karwantes/Nuaire-MVHR/docs/images/bus_connector_front.jpg

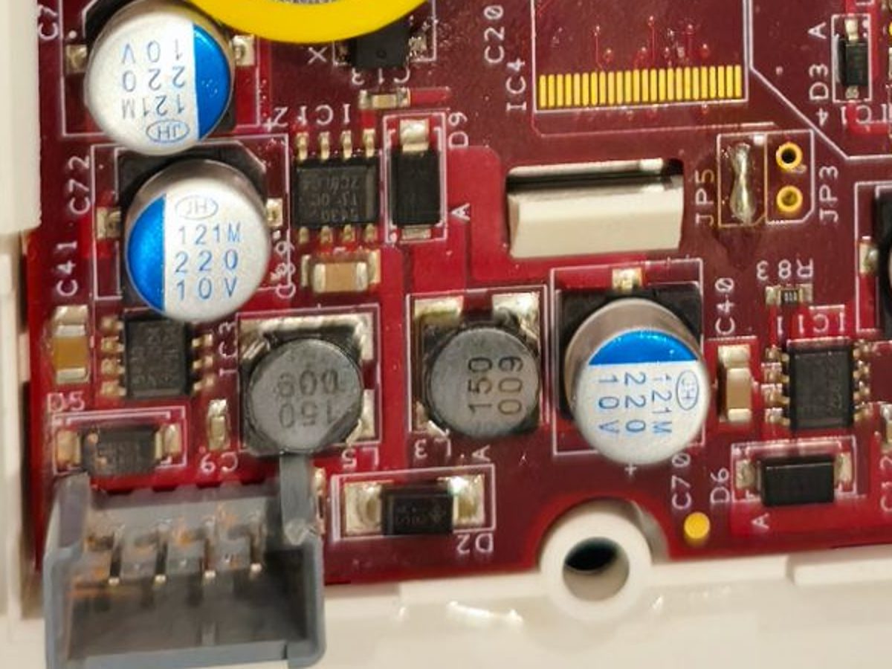
docs/images/bus_connector_front.jpg
