karwantes/Nuaire-MVHR/docs/images/bus_pads_back.jpg

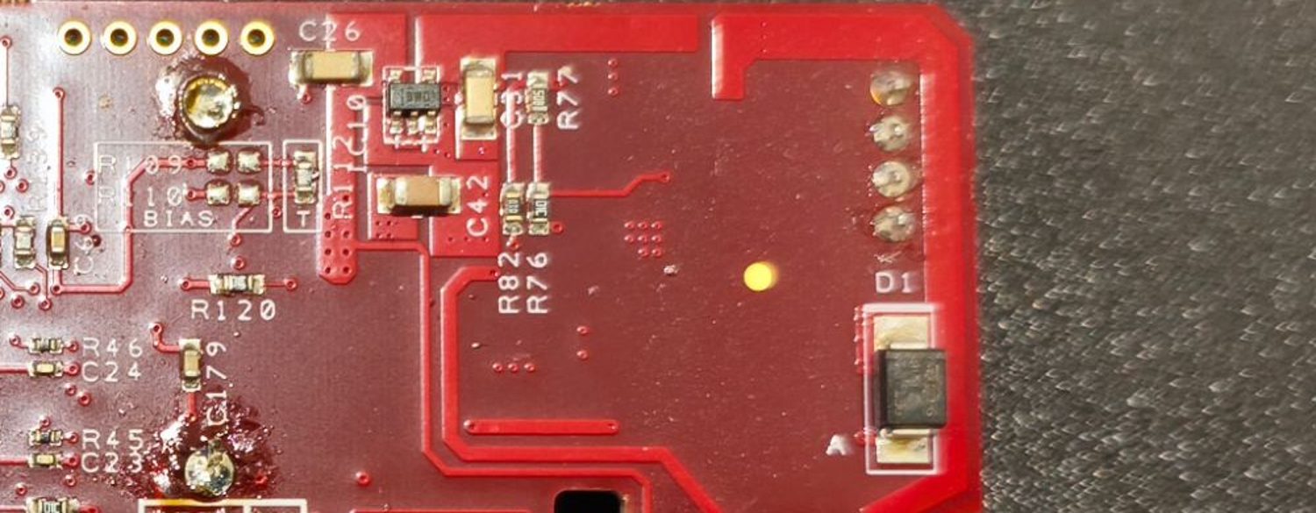
docs/images/bus_pads_back.jpg
