karwantes/Nuaire-MVHR/card/qa/screenshots/aircon-off-phone.png

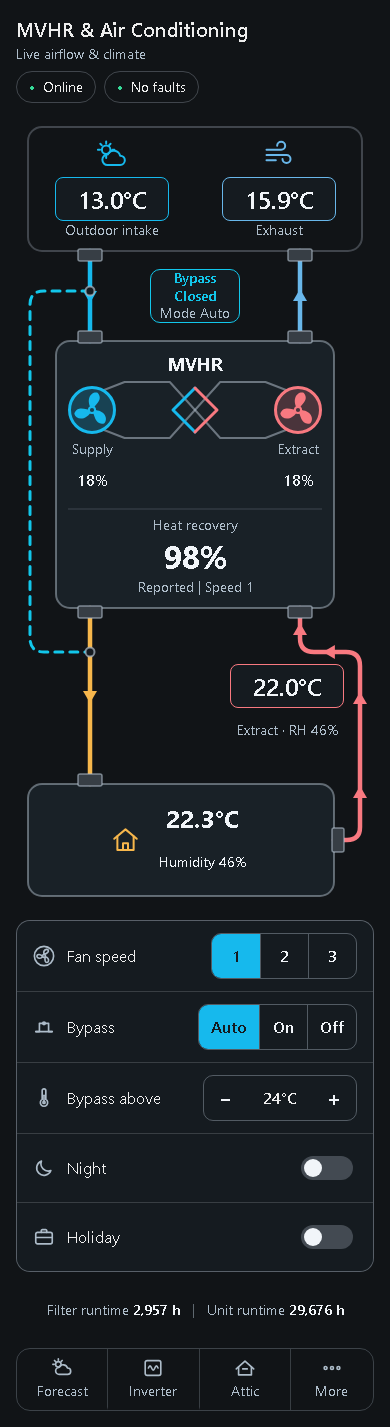
card/qa/screenshots/aircon-off-phone.png
