karwantes/Nuaire-MVHR/card/qa/screenshots/aircon-off-tablet.png

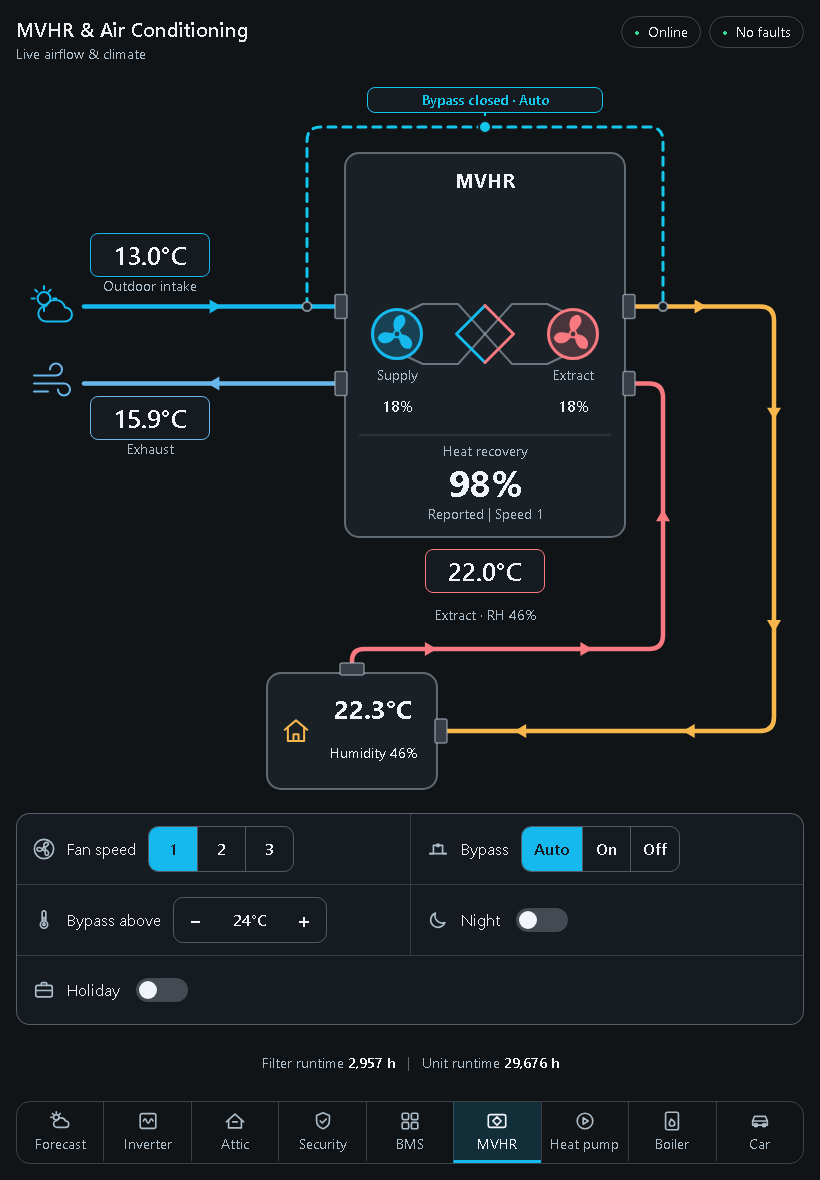
card/qa/screenshots/aircon-off-tablet.png
