karwantes/Nuaire-MVHR/card/qa/screenshots/both-off-desktop.png

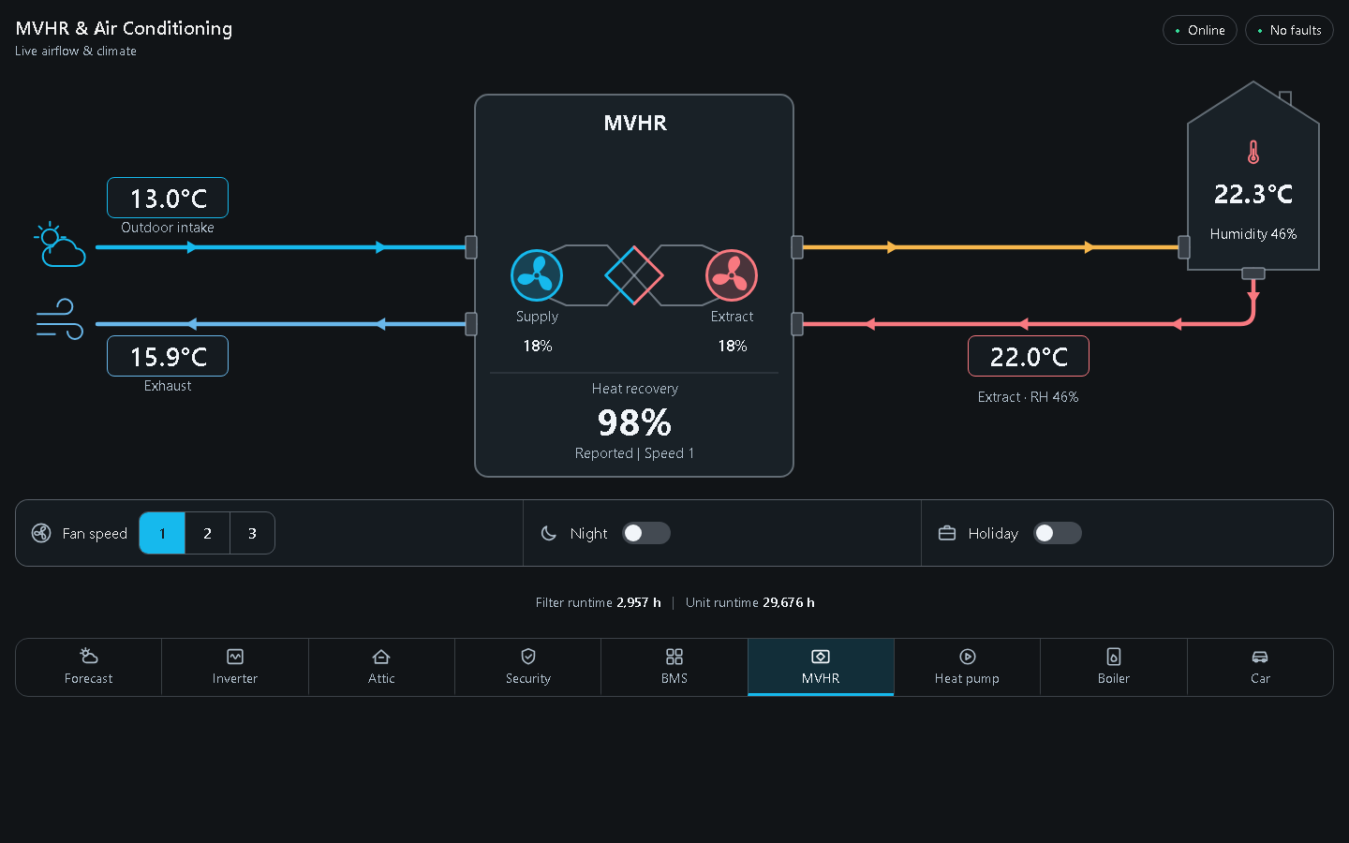
card/qa/screenshots/both-off-desktop.png
