karwantes/Nuaire-MVHR/card/qa/screenshots/both-off-phone.png

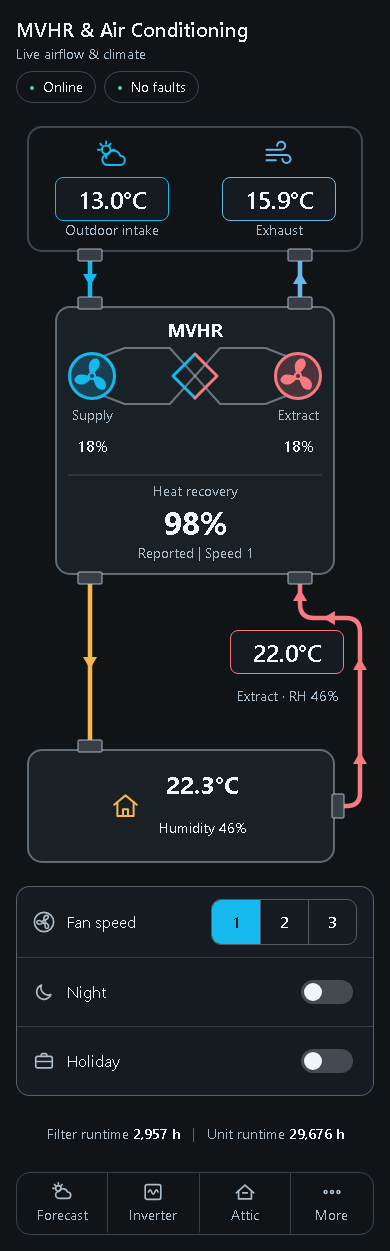
card/qa/screenshots/both-off-phone.png
