karwantes/Nuaire-MVHR/card/qa/screenshots/both-off-tablet.png

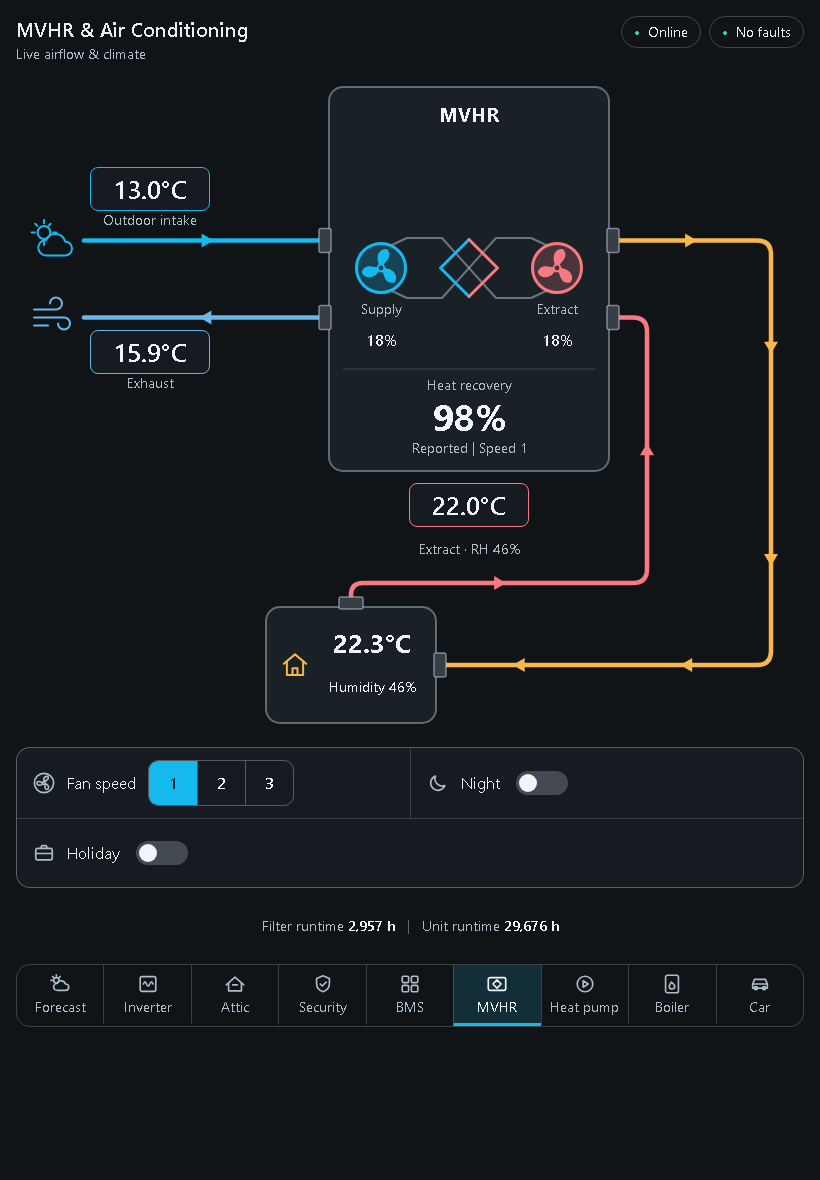
card/qa/screenshots/both-off-tablet.png
