karwantes/Nuaire-MVHR/card/qa/screenshots/bypass-off-desktop.png

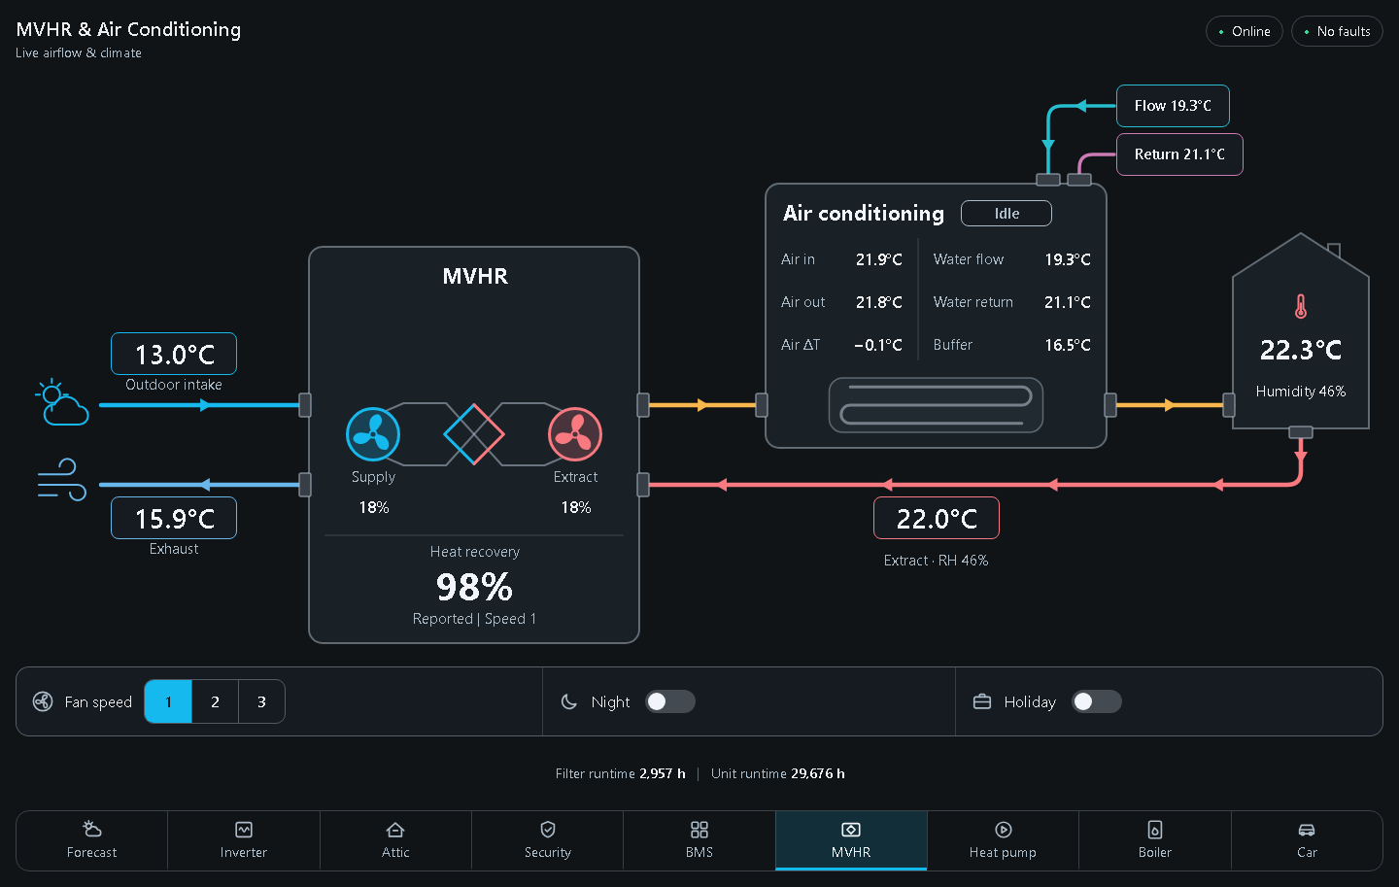
card/qa/screenshots/bypass-off-desktop.png
