karwantes/Nuaire-MVHR/card/qa/screenshots/bypass-off-phone.png

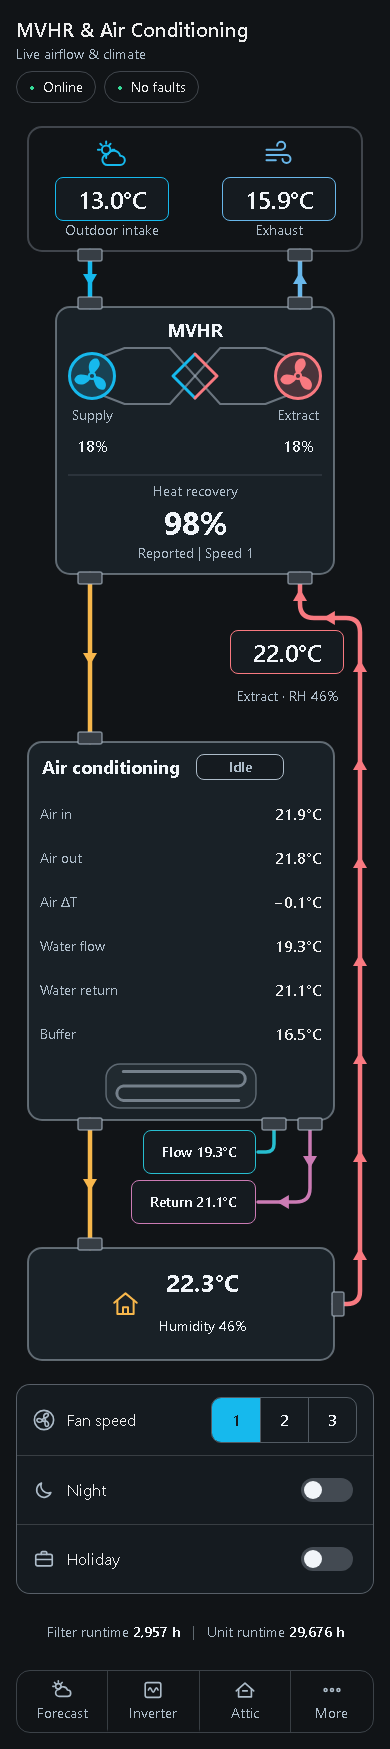
card/qa/screenshots/bypass-off-phone.png
