karwantes/Nuaire-MVHR/card/qa/screenshots/bypass-off-tablet.png

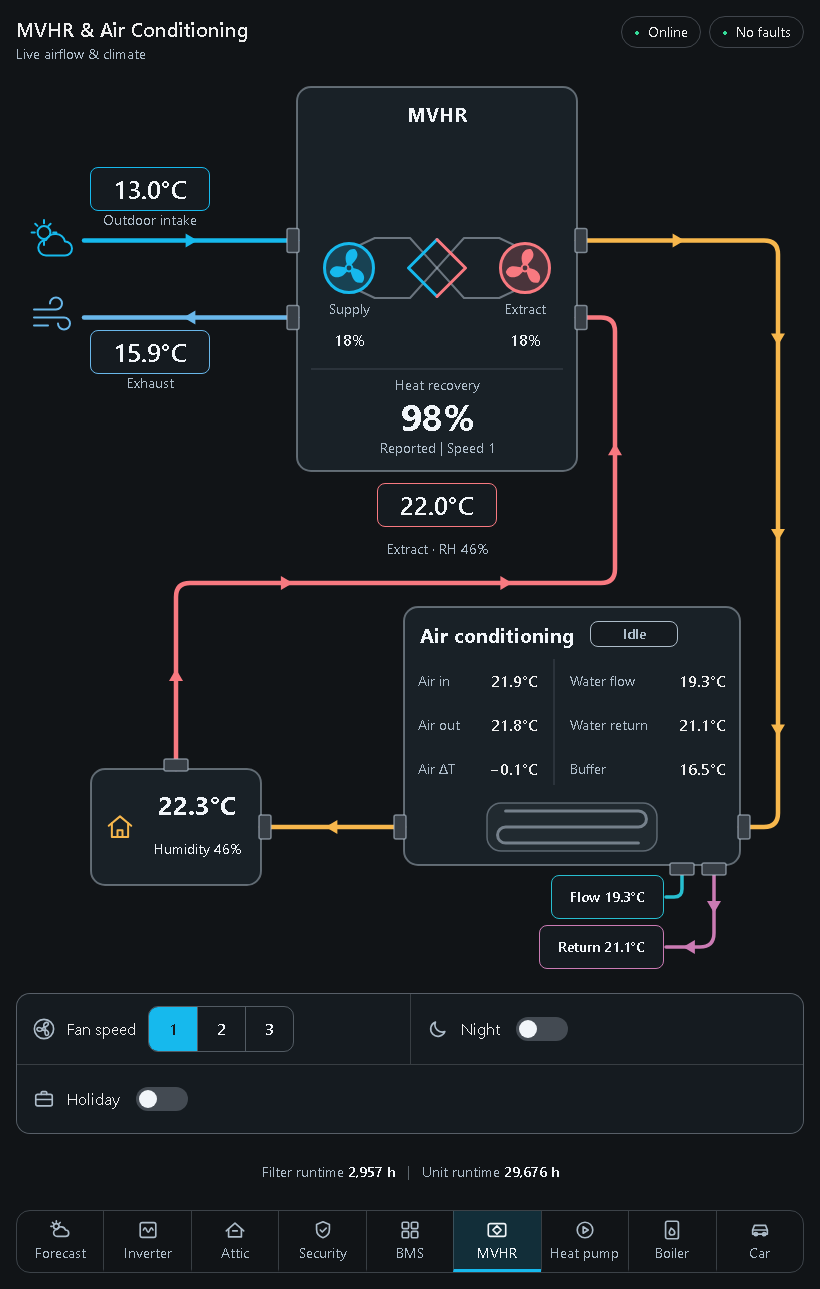
card/qa/screenshots/bypass-off-tablet.png
