karwantes/Nuaire-MVHR/card/qa/screenshots/controls-off-desktop.png

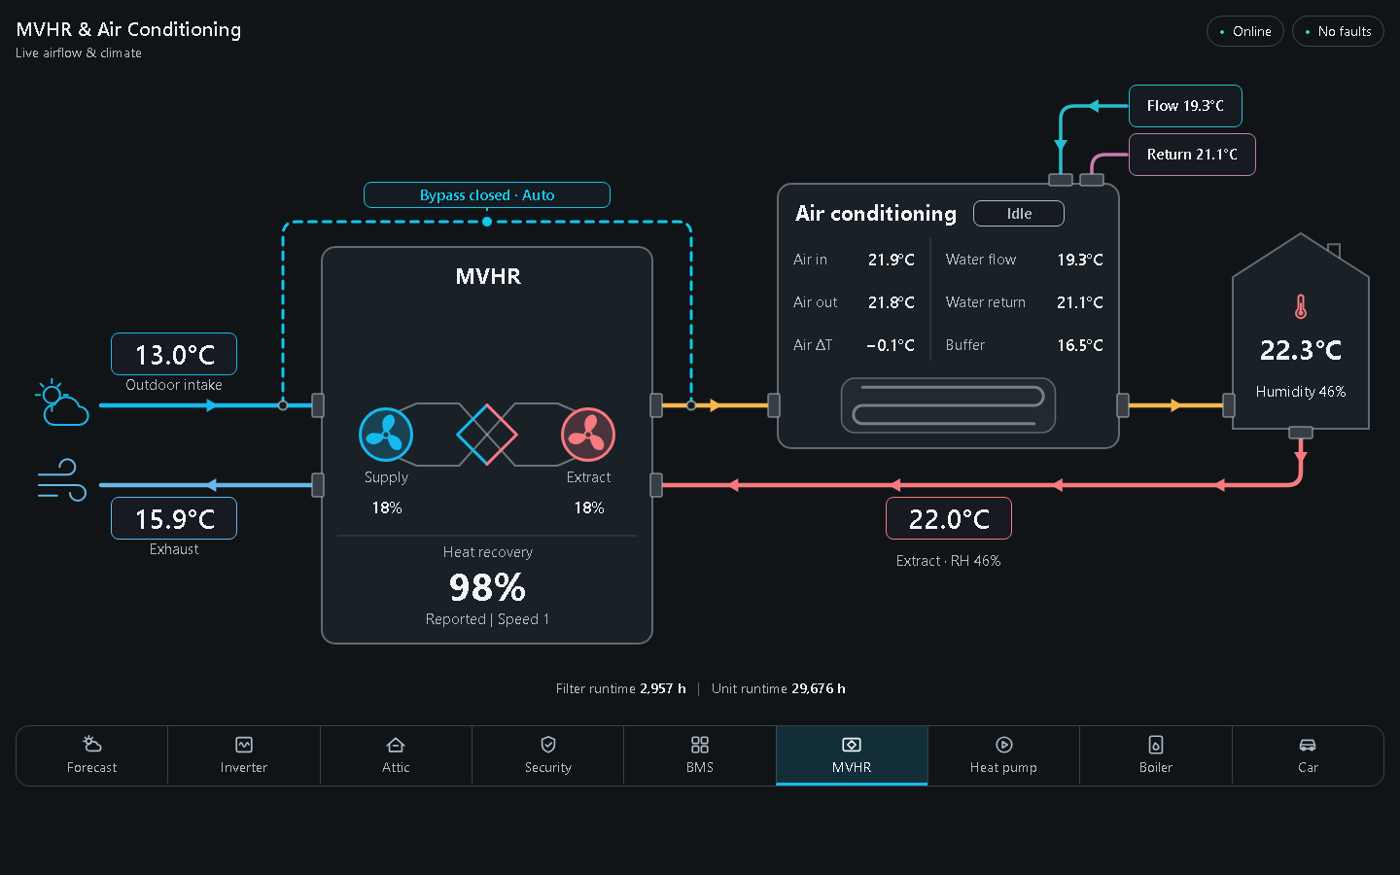
card/qa/screenshots/controls-off-desktop.png
