karwantes/Nuaire-MVHR/card/qa/screenshots/controls-off-phone.png

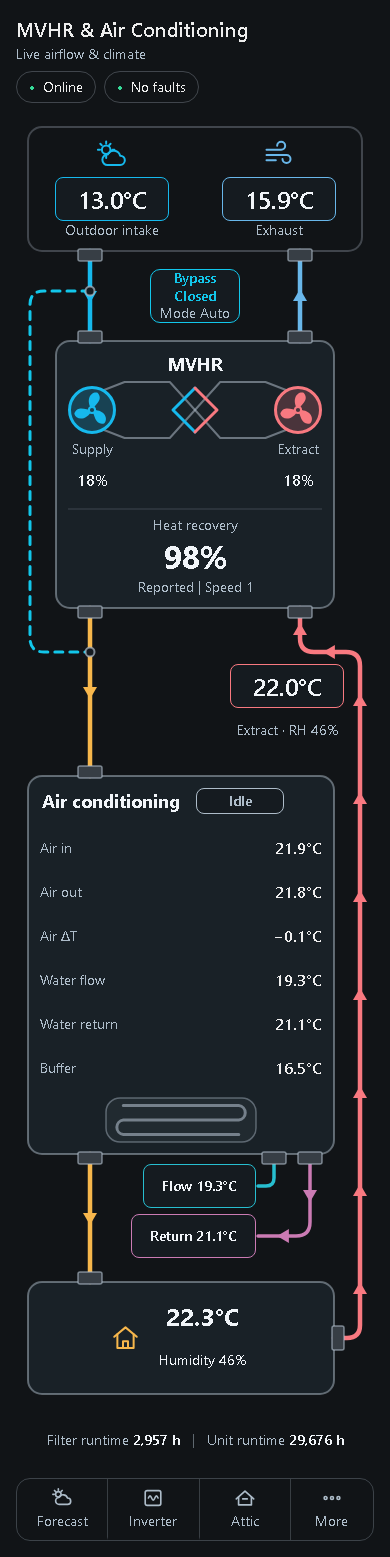
card/qa/screenshots/controls-off-phone.png
