karwantes/Nuaire-MVHR/card/qa/screenshots/controls-off-tablet.png

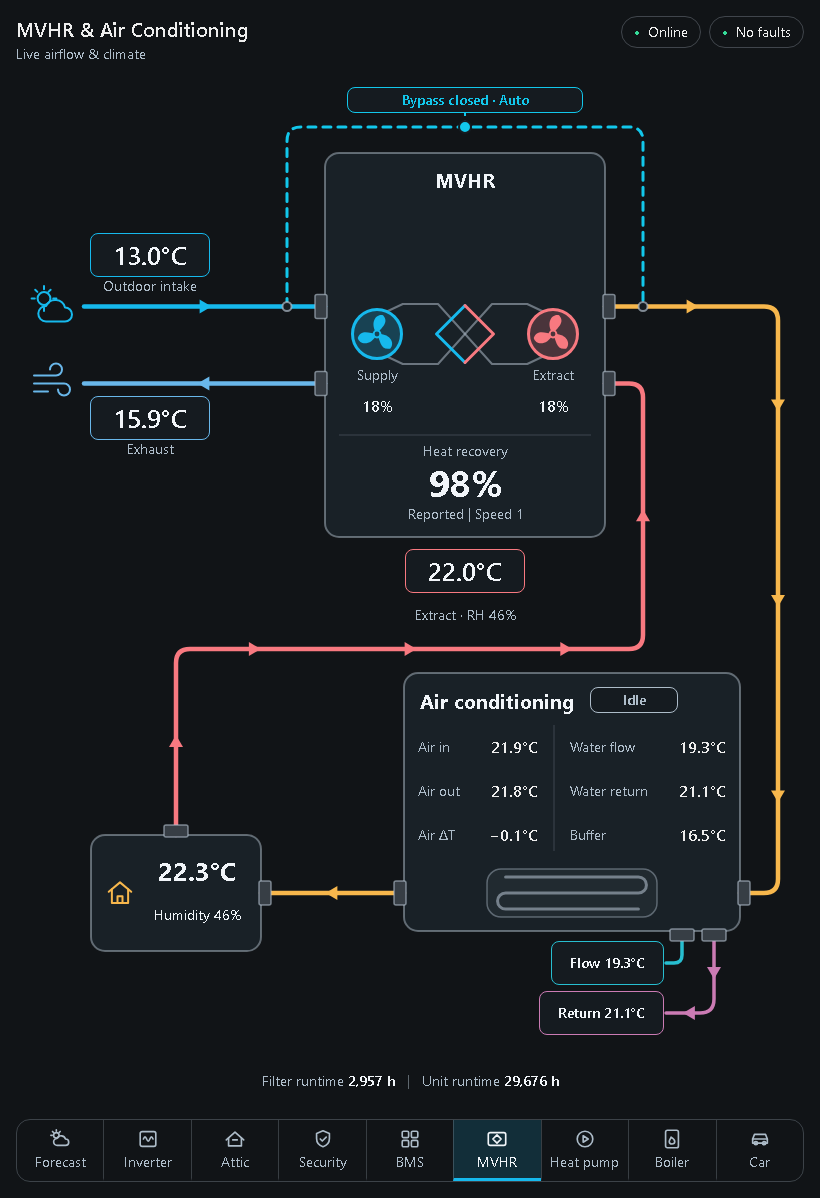
card/qa/screenshots/controls-off-tablet.png
