karwantes/Nuaire-MVHR/card/qa/screenshots/demo-desktop.png

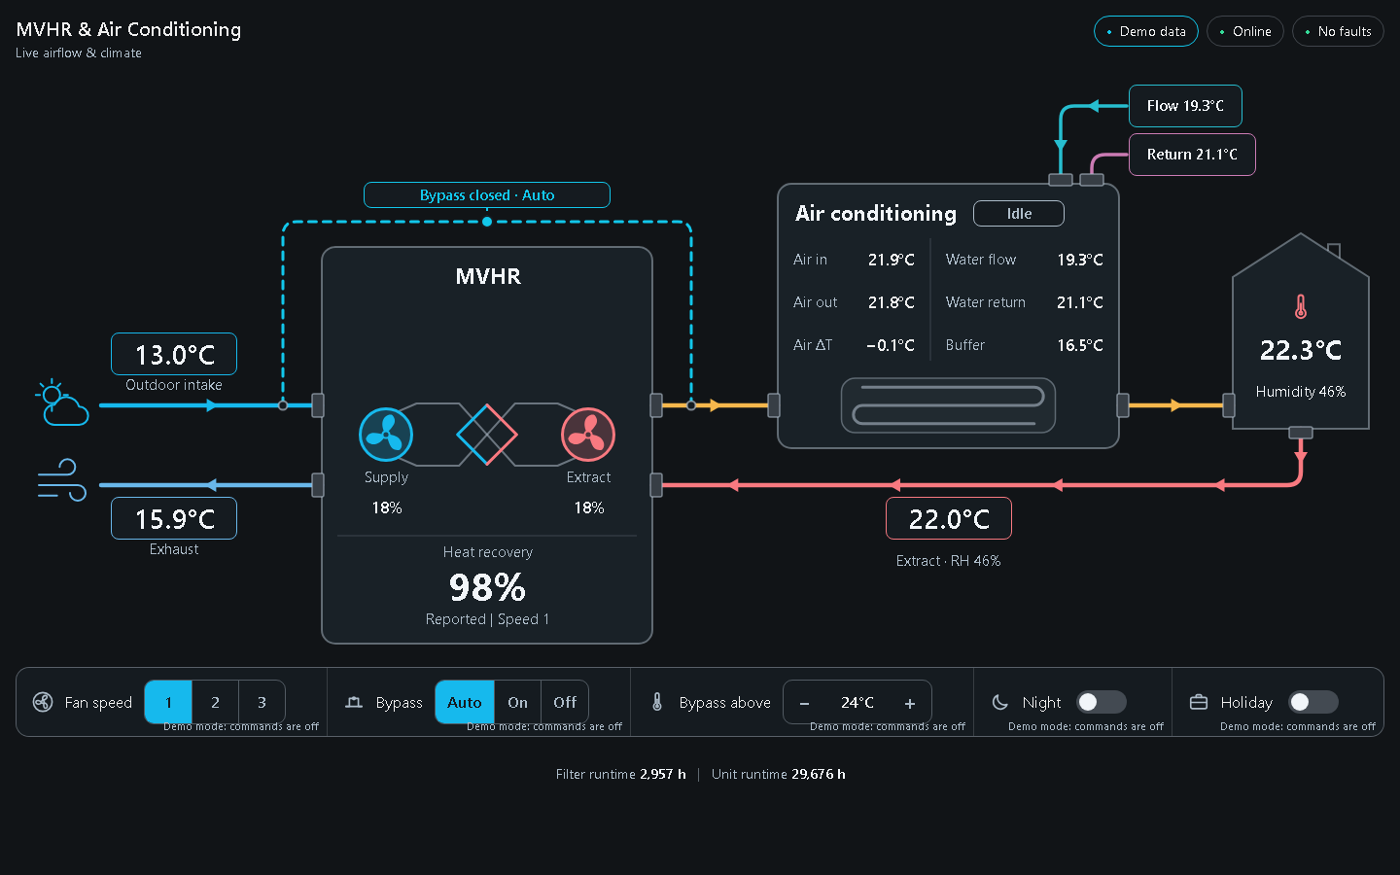
card/qa/screenshots/demo-desktop.png
