karwantes/Nuaire-MVHR/card/qa/screenshots/full-tablet.png

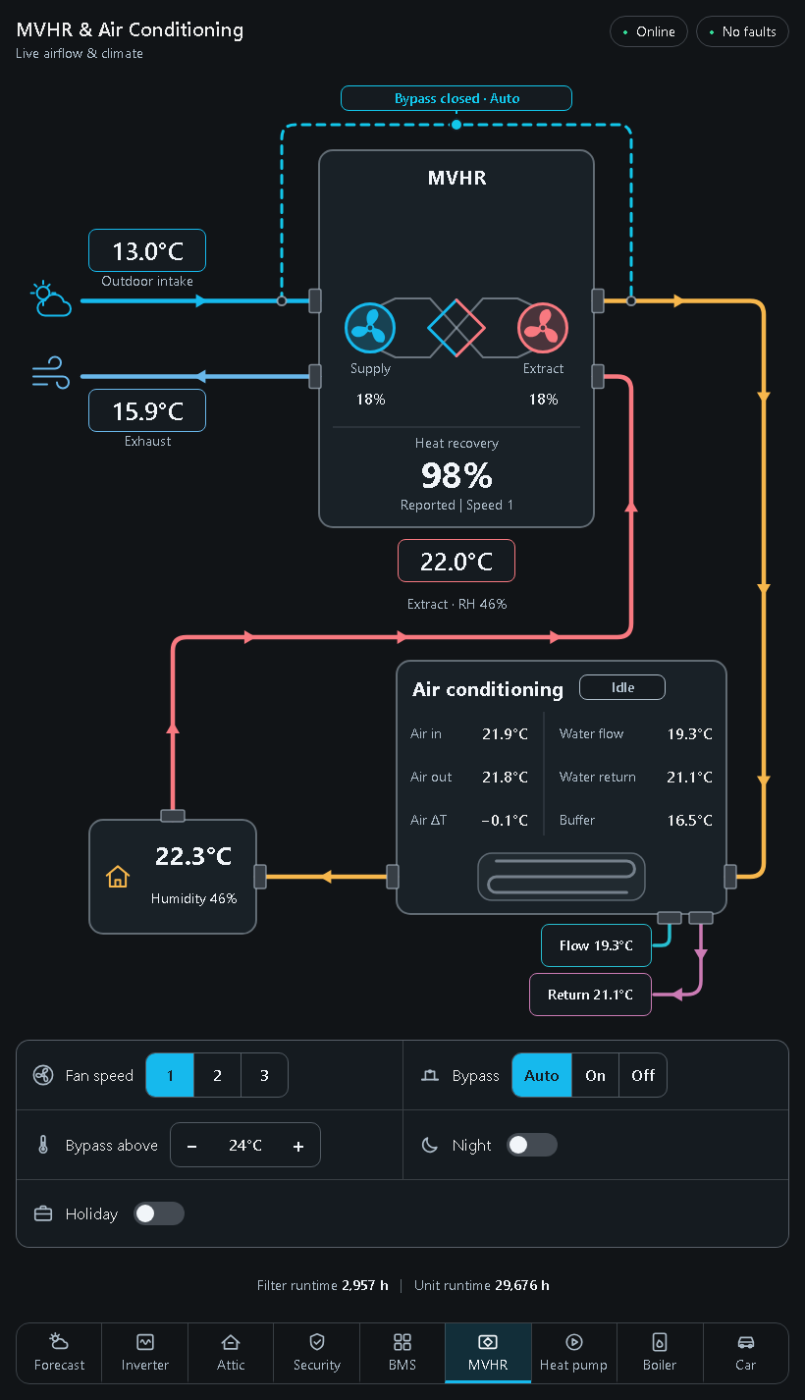
card/qa/screenshots/full-tablet.png
