karwantes/Nuaire-MVHR/card/qa/screenshots/metrics-minimal-desktop.png

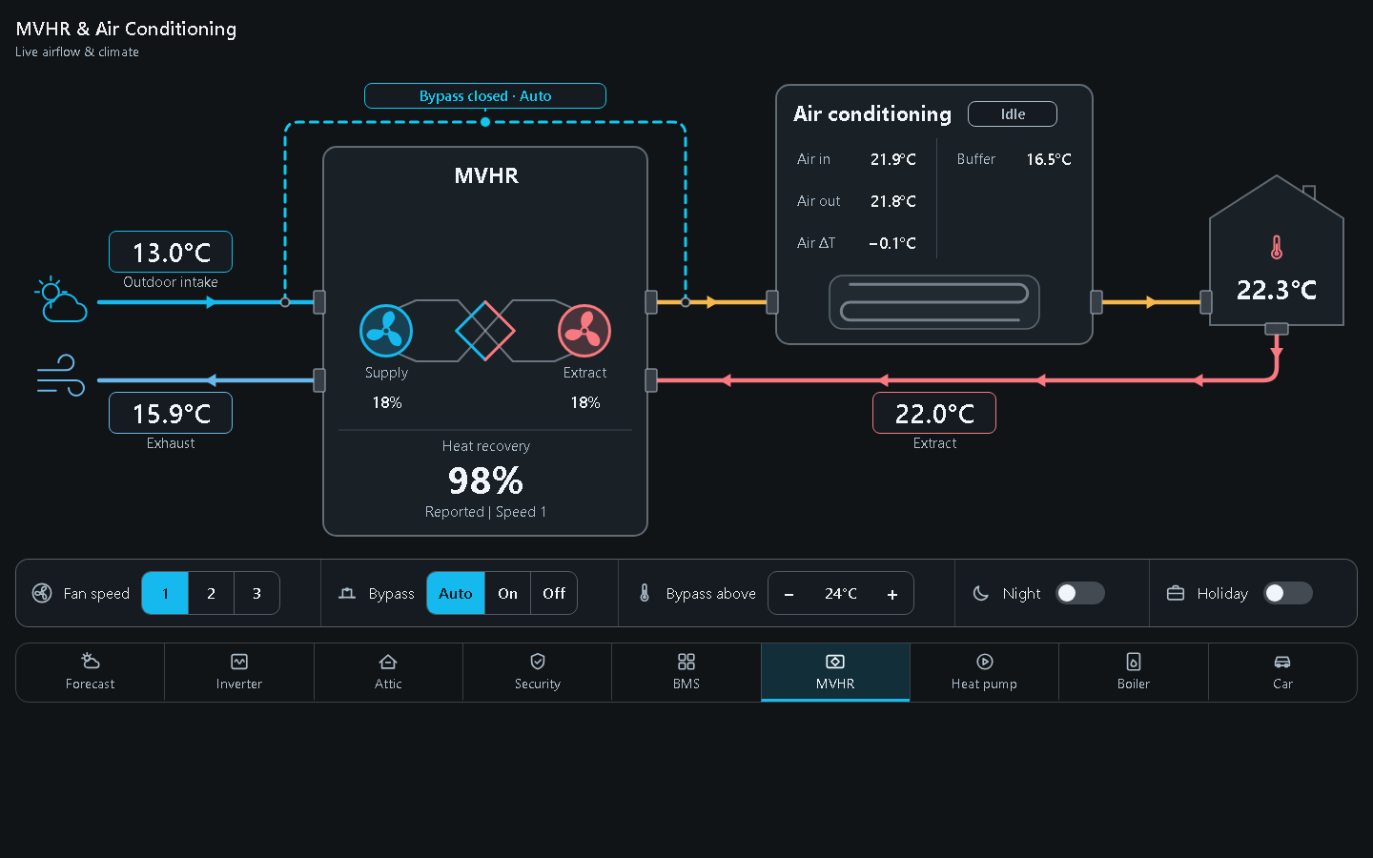
card/qa/screenshots/metrics-minimal-desktop.png
