karwantes/Nuaire-MVHR/card/qa/screenshots/metrics-minimal-phone.png

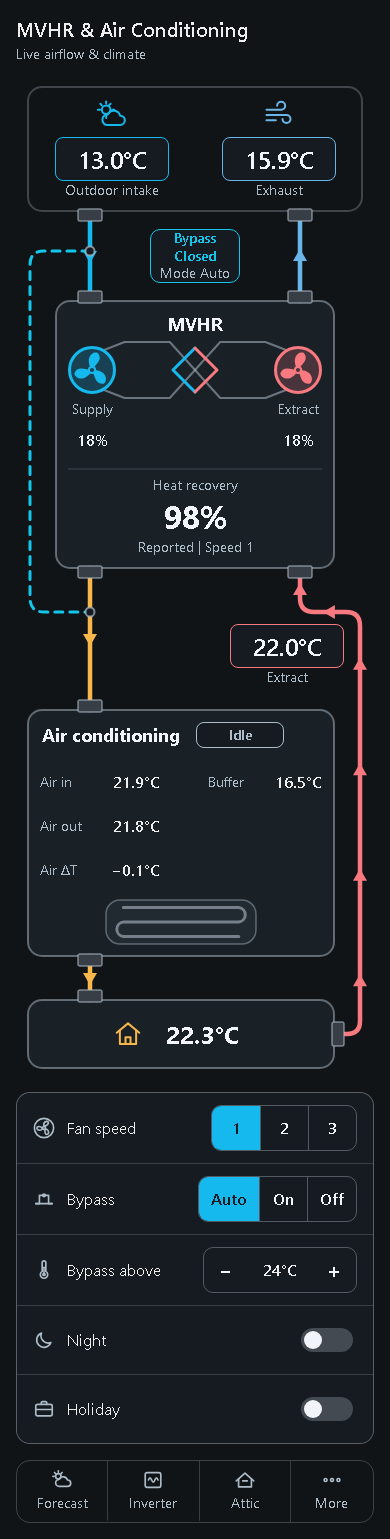
card/qa/screenshots/metrics-minimal-phone.png
