karwantes/Nuaire-MVHR/card/qa/screenshots/metrics-minimal-tablet.png

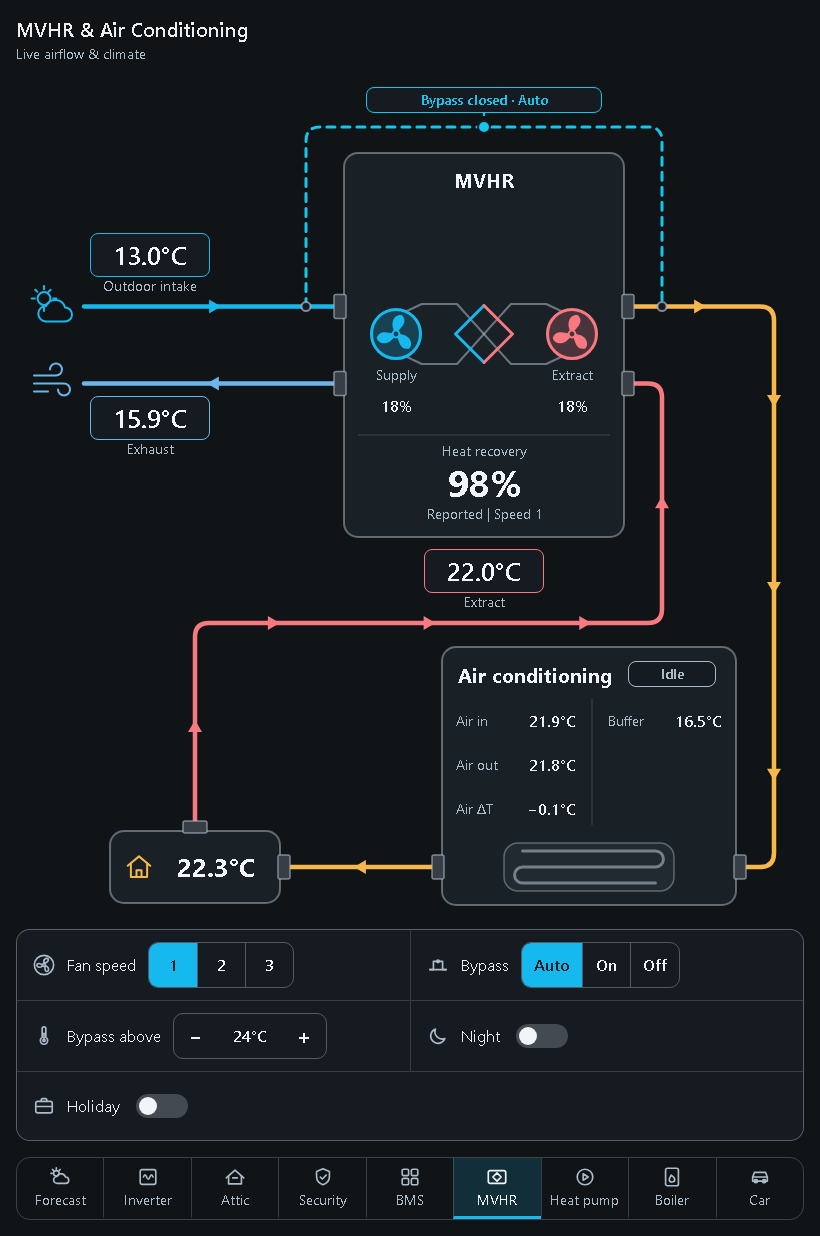
card/qa/screenshots/metrics-minimal-tablet.png
