karwantes/Nuaire-MVHR/card/qa/screenshots/nav-off-phone.png

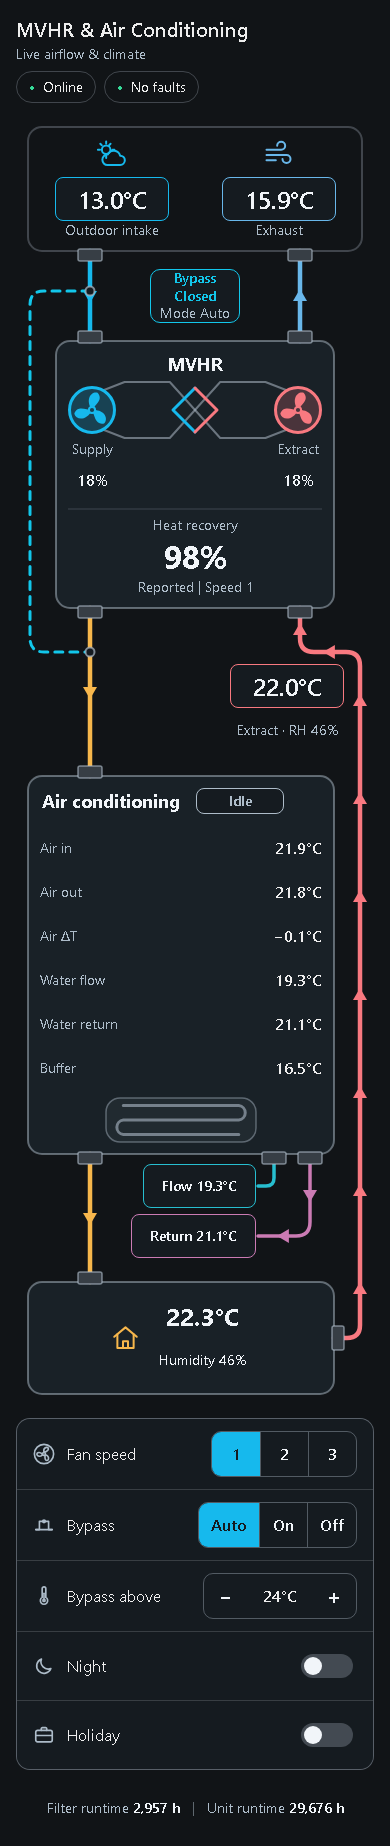
card/qa/screenshots/nav-off-phone.png
