karwantes/Nuaire-MVHR/card/qa/screenshots/nav-off-tablet.png

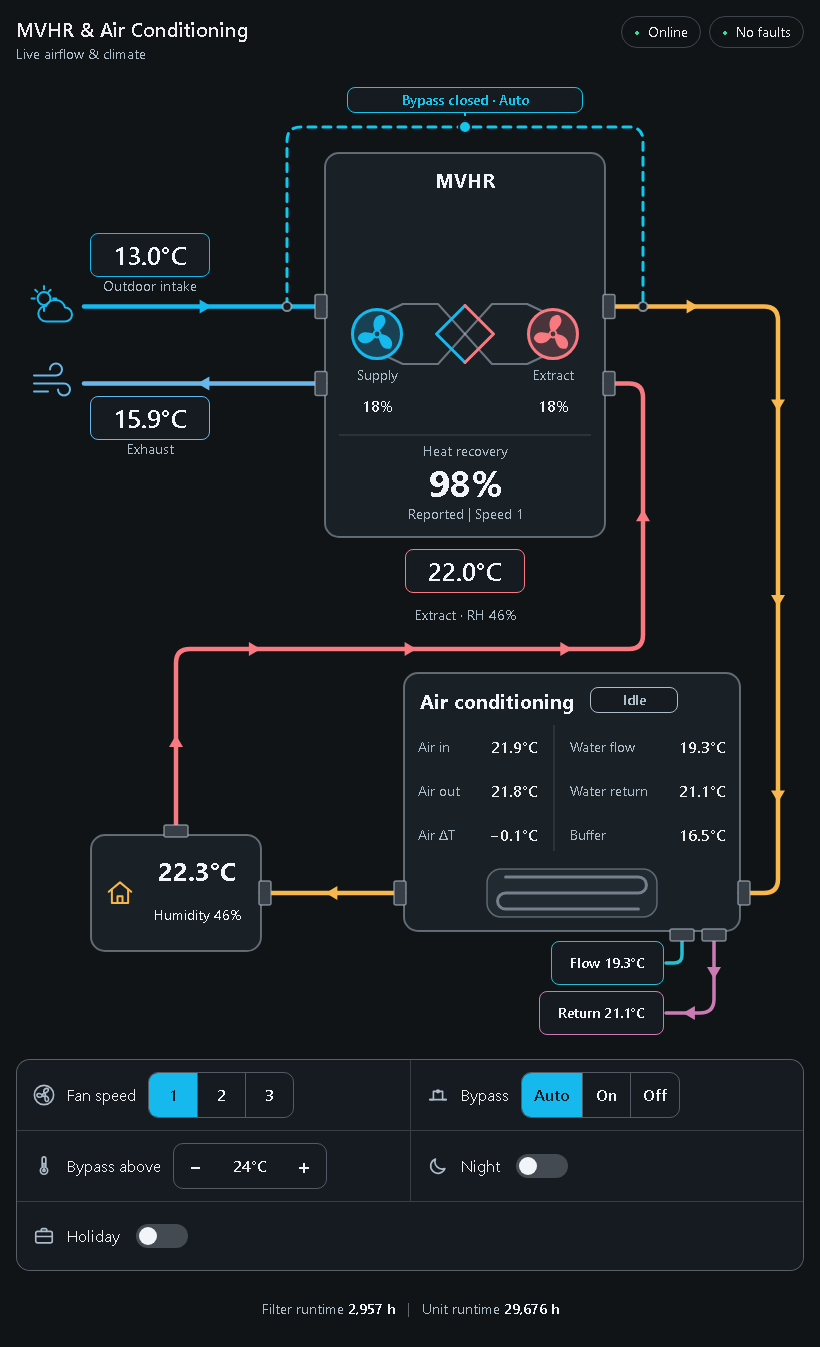
card/qa/screenshots/nav-off-tablet.png
