karwantes/Nuaire-MVHR/(commit log)

2026-10-23 Add VSC protocol notes, I2C logger, tools and captures
    - docs/protocol.md: I2C framing, status payload, settings frame, menus
    - logger/: LD_PRELOAD I2C logger with live debug pages, zig build script
    - tools/: SD image builder, log extractor, es-lcd disassembler, logo maker
    - captures/: two real I2C logs from the unit
    - README with status, usage, image hashes and the ESP32 plan
2026-10-23 Add I2C capture run 3 (26 min boost) and protocol notes
    - captures/i2clog_run3.txt: 29-minute log, mostly req 0d
    - RH examples 43-48 %, reply header echo of TX d1..d8 in run 3
2026-10-23 Add bus cable wiring, annotated board photos and RS485 cross-reference
    Measured on the wall cable: red +10 V supply, blue 0 V, green RS485 A,
    yellow RS485 B. Annotated front/back photos of the VSC board, and the
    jamesgrogantech RS485 capture lined up against the I2C fields.
2026-10-23 Add ESP32 serial console bridge, mkimg --shell, and VSC boot/shell capture
    - esp/vsc-serial-bridge: WiFi bridge to the LINUX TERMINAL header (web + telnet),
    OTA, RS232/TTL polarity switch saved in flash
    - tools/mkimg.py --shell: run es-lcd in the background so getty gives a root login
    - captures/vsc_console_boot.txt: stock boot log and a root shell session
    - README: console status, --shell usage, bridge notes
2026-10-23 Add Buy Me a Coffee banner and sponsor button
2026-10-24 Dark screen theme, HASSOS mode and docs
    - i2clog.c: theme support (when images/.dark exists), Settings tick box for
    "Controlled by HASSOS", and errno via es-lcd's own GOT so it boots preloaded.
    - build.sh: no imports at all (the unit's ld never binds a preloaded PLT).
    - theme/: darken.py and overview.py, plus README on making and installing
    your own screens and what HASSOS mode does.
    [i2clog.c]
2026-10-24 Bypass control and Home Assistant MQTT bridge
    - i2clog: bypass on/off/auto and setpoint through /tmp files, /tmp/bypass_state
    - ESP bridge: RS485 bus listener, MQTT discovery for fan speed 1/2/3,
    bypass, setpoint and bypass state (broker set on the device, not in code)
    - docs: bypass timers and status bit, control files, HA screenshot
    [i2clog.c, vsc-serial-bridge.ino]
2026-10-24 Airflow control, debug logging to Home Assistant, file upload over the bridge
    - i2clog.c: /tmp/airflow sets supply/extract % for speed 1/2/3, /tmp/airflow_state reports them.
    Debug logging is now off by default; /tmp/debug turns it on (file + console @L lines).
    - Bridge: six airflow numbers and a Debug logging switch in HA, debug lines on vsc/log
    and batched on vsc/log_batch (Debug log sensor, readable from HA history).
    - Bridge: /upload sends a file to the VSC over the console, with md5 check.
    - Docs: README, bridge README, theme README and protocol notes explain the above.
2026-10-24 Humidity, temperatures, running speed and fault sensors in Home Assistant
    i2clog.so writes /tmp/sensors (extract and intake temperature, humidity,
    running fan speed, raw p8/p9 fault bytes). The running speed comes from the
    unit's p7 acknowledgement, as the p9 speed bits stay at speed 1.
    The bridge adds Humidity, Extract/Intake air temperature, Running fan speed,
    Communication with unit and the fault sensors over MQTT discovery.
    Requires further testing: Heater fault and Test routine required.
2026-10-24 Save HA settings on the VSC, add night/holiday, frost, humidity and screen timeout
    - Airflow, bypass setpoint, humidity and frost are saved through es-lcd's own
    setup3 save routine, so they last across a restart.
    - Frost, night and holiday are also kept in /etc/modes and applied at start
    (es-lcd's loader doesn't restore the frost bits).
    - Screen timeout is saved in /etc/screen_timeout (0 = never sleep).
    - Heater fault, Cooler fault and Test routine required marked as requiring
    further testing.
    - Docs: new /tmp and /etc files, setup3 save/loader, screen sleep, p13/p14.
    [i2clog.c, vsc-serial-bridge.ino]
2026-10-24 Card converter: vscconv.exe converts a stock VSC card in a PC reader, with a checked backup and restore
    Step-by-step guide with parts list and wiring diagram for the ESP32 console bridge.
2026-10-24 Convert guide: 10k resistor listen-only quick check with diagram
2026-10-24 Bridge: show the VSC offline when it stops answering; README start-here section
    After 3 unanswered polls the bridge publishes vsc/vsc_status offline and
    comms OFF; the unit's entities use it as a second availability topic, so
    HA shows them unavailable instead of stale values. Tested unplugged and
    plugged back in.
    README: a "Home Assistant with an ESP32: start here" section explaining
    how the card, library, ESP32 and HA fit together.
2026-10-24 Docs: step-by-step setup, revised conversion guide
    - README: 9-step setup including ESP WiFi and MQTT configuration
    - convert-card.md: rewritten (tested setup, HA/MQTT prep, ESP flashing,
    acceptance checklist, troubleshooting, restore and recovery)
    - console-listen-only.md: experimental resistor check moved out of the guide
    - Bridge README: network security note, 2.4 GHz WiFi
    - Converter README: restore details, WSL2 round trip tested
2026-10-24 Converter: es-lcd build check, required .sha256, blank-card restore; bridge: wait for shell before first login
    - vscconv.py: convert refuses (nothing written, no backup) unless es-lcd is the
    tested build; override with --any-eslcd or "yes" in the menu. status shows it.
    - Restore needs a matching .sha256 and refuses before opening the target.
    - Menu option 5 restores to a blank or other card, with the disk number typed
    again to confirm; the system disk is never listed.
    - Bridge: poll sends only Enter until the "# " prompt is seen, HA commands wait
    for the shell, root is sent once at login:. Tested on a real VSC reboot.
    - Docs updated; blank-card restore requires further testing.
    [vsc-serial-bridge.ino]
2026-10-24 Add HA custom integration for a USB serial dongle on the VSC console (experimental)
    custom_components/nuaire_mvhr runs the ESP bridge's console logic inside Home
    Assistant: root login, the 20 s poll and the same shell commands, giving the same
    entities as the bridge's MQTT discovery. The ESP bridge stays on MQTT.
    Tested in HA 2026.10 against a simulated console over socket://. Requires further
    testing on a real VSC with a USB-RS232 dongle.
2026-10-24 Clock sync, Clock entity, speed and screen sleep fixes
    Bugs fixed:
    1. A fan speed change on the screen didn't update HA's Fan speed (only
    Running fan speed). The library now writes /tmp/speed2 and /tmp/speed3
    back when the screen changes speed.
    2. Leaving the hidden debug page left the screen sleep countdown at 0, so
    the screen never slept. The countdown now restarts on exit.
    3. The unit's clock had stopped, which stopped every per-minute countdown:
    screen sleep, the speed 2/3 timers, night and holiday. The library now
    writes the clock to /tmp/clock; the ESP bridge reads it on every poll,
    gets the time by NTP (time zone on the MQTT page, UK by default) and
    sets the clock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
    [i2clog.c, vsc-serial-bridge.ino]
2026-10-25 RS485 bus tap working (WIP): XY-485 wiring, edge counter, first decode
    - Bridge: hold GPIO26 (TXD) high from boot so an auto-direction XY-485
    stays in receive; count GPIO25 edges (bus_edges/bus_level in /status).
    - README: tested XY-485 wiring (VCC on VIN, A+ yellow, B- green, GND to
    blue), module photos and links to the parts used.
    - protocol.md: first decode of the broadcast, requires further testing:
    7-bit framing, XOR-to-D5 checksum, humidity in DC byte 1, fan speed in
    8A byte 2. Temperatures not found yet.
2026-10-25 README: control options
    The four ways to control the unit (serial console, I2C on a stock card,
    I2C with the HASSOS tick box, ESP on RS485 without the VSC) and their status.
2026-10-25 Option 4: ESP replaces the VSC on RS485, setup portal
    VSC emulation in the bridge: with the VSC powered off, the ESP answers the
    unit's 88/8A/AE/C5 polls (speed, modes, setpoints, airflow) and keeps
    es-lcd's state the bus never carries: speed 3, night, holiday and bypass
    override timers, run and filter hours. HA switch "VSC emulation".
    Validated on one unit with the VSC powered off.
    Setup portal: "/" is now setup and status (Wi-Fi scan and join, MQTT,
    restart); the console page moves to /console. The setup network comes up
    on first boot, after a minute without Wi-Fi or with BOOT held 3 s, sends
    phones to the setup page, and turns off after 5 min unused.
    Docs: option 4 how-to with the emula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
    [vsc-serial-bridge.ino]
2026-10-25 Add Nuaire MVHR dashboard card (alpha)
    The integration serves custom:nuaire-mvhr-card. Air flow diagram with optional coil,
    clickable entities, controls row, GUI editor, portrait/landscape scaling, and room for
    a fixed bottom bar. Integration version 0.2.0-alpha. Requires further testing.
2026-10-25 Card 0.2.3-alpha: option to invert the bypass sensor
    Some units report Bypass active on while the damper is shut and all air goes through the exchanger. The new invert_bypass option draws those the right way round.
2026-10-25 Card 0.2.4-alpha: layout fixes
    - Keep a gap between the controls and a fixed bottom bar.
    - One outline per box (drop the accent bar that read as a double line).
    - Heat exchanger airflow text uses the short form when the long one doesn't fit.
    - Drop the fin lines; draw the bypass duct only while the bypass is open.
2026-10-25 Card 0.2.5-alpha: symmetric landscape layout
    Outdoor boxes on the left, house and coil on the right, the exchanger
    centred, supply above the centre line and extract below it. The bypass
    duct is still drawn only while the bypass is engaged.
2026-10-25 Two options: no VSC (RS485) and VSC console; docs tidy-up
    - Option 1 how-to (docs/option1-no-vsc.md, was option4) and option 2
    how-to (docs/option2-vsc-console.md, was convert-card.md) with wiring
    diagrams and photos: 10k resistor console wiring, 5 V buck power.
    - Remove the listen-only doc and the old I2C/listen-only material.
    - protocol.md rewritten; build-logger-card.md split out of the README.
    - Shorter main README with both options near the top.
    - Bridge: /unit page for both options, header comments updated;
    bridge README rewritten for the two options.
    - Fix stale links (convert-card, theme anchors), MSP430 -> bus chip.
    [vsc-serial-bridge.ino]
2026-10-26 Card 0.3.0-alpha: HACS install, install guide, README
    - New MVHR airflow card (card/): GUI editor, panel view, Edit card button,
    fill from unit, read-only by default, tests and QA results.
    - Fill from unit turns the air conditioning coil off when the unit has no
    coil sensors.
    - hacs.json and dist/mvhr-airflow-card.js so HACS can install the card;
    the build copies the bundle there.
    - card/docs/install.md: prerequisites, My Home Assistant button, manual
    install, setup, turning air conditioning off, troubleshooting.
    - README: dashboard card section with the HACS button and install link.
    - Remove the old custom_components/nuaire_mvhr integration.
2026-10-26 Card: show heat recovery as Off while the bypass is open
    An open bypass sends the air round the exchanger, so a recovery figure
    is misleading. The card now shows Off with Bypassed in the sub line.
    The demo fixture now has the bypass closed so its 98% is consistent.
    QA screenshots regenerated for the new demo state.
